LucasB1910/LB_Prak26_CottonCandyFlavour/media/flavor_station_angled_view.jpeg

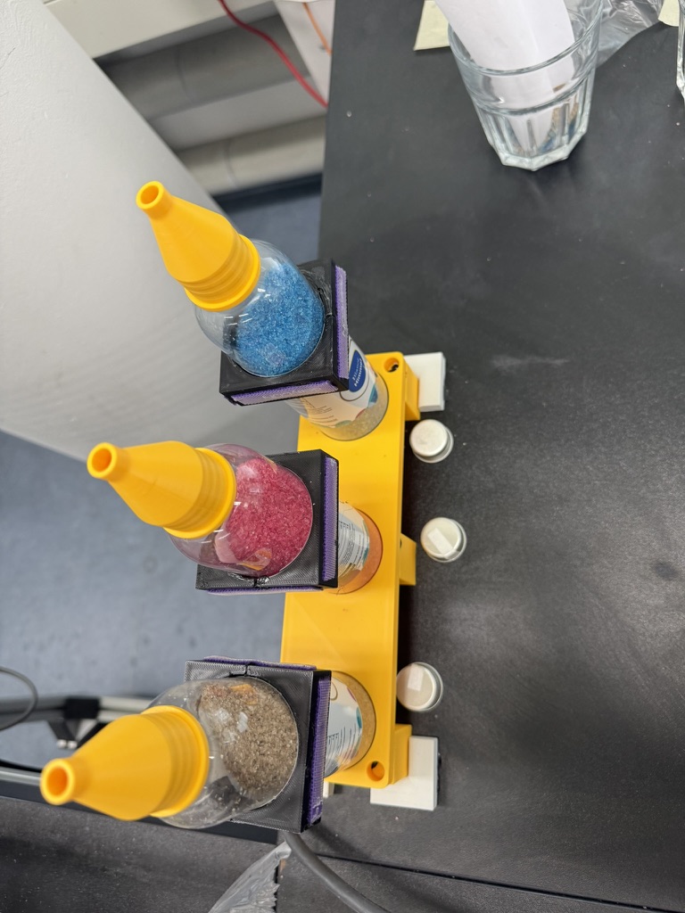
media/flavor_station_angled_view.jpeg
