LucasB1910/LB_Prak26_CottonCandyFlavour/media/flavor_station_docking_view.jpeg

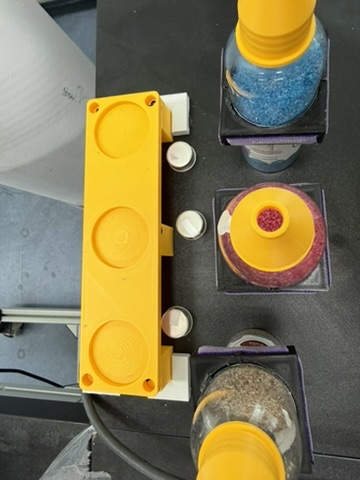
media/flavor_station_docking_view.jpeg
