LucasB1910/LB_Prak26_CottonCandyFlavour/hardware/3d-prints/final_funnel_9.5mm_opening.stl

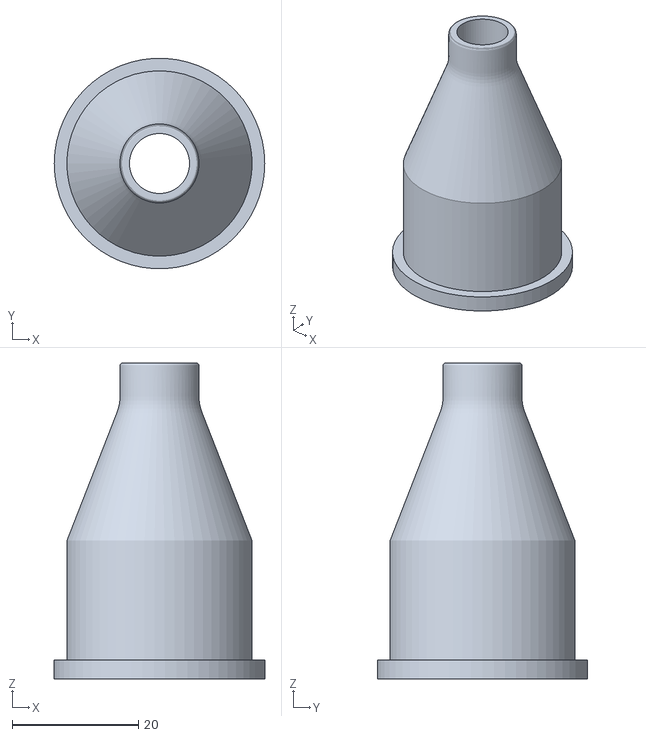
[picture p7: CAD file, 2026-07-26]
hardware/3d-prints/final_funnel_9.5mm_opening.stl
33.3 x 33.3 x 50.0
