LucasB1910/LB_Prak26_CottonCandyFlavour/hardware/3d-prints/final_sugar_gripper_v2.stl

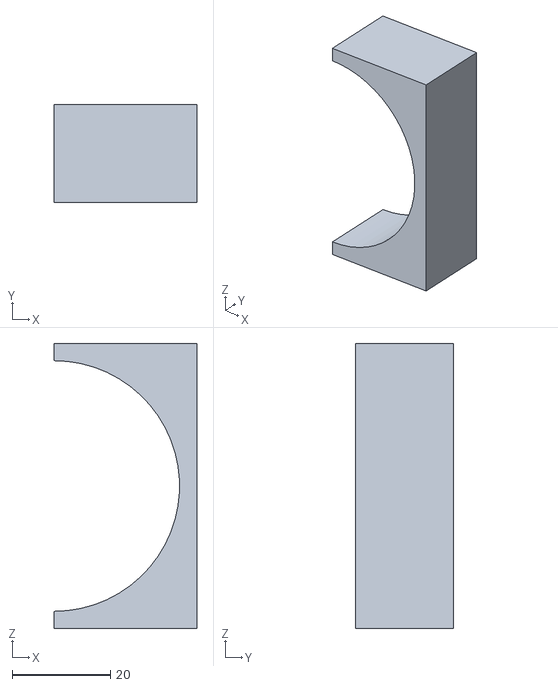
[picture p9: CAD file, 2026-07-26]
hardware/3d-prints/final_sugar_gripper_v2.stl
29.0 x 20.0 x 58.0
