LucasB1910/LB_Prak26_CottonCandyFlavour/hardware/3d-prints/final_sugar_bottle_holder.stl

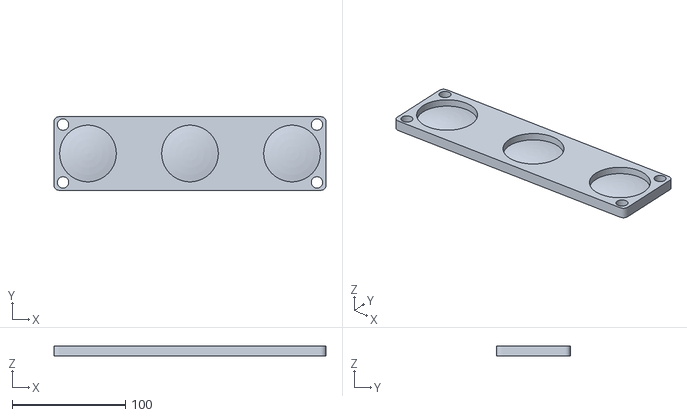
[picture p10: CAD file, 2026-07-26]
hardware/3d-prints/final_sugar_bottle_holder.stl
240.0 x 65.0 x 9.00
