LucasB1910/LB_Prak26_CottonCandyFlavour/hardware/3d-prints/archive/funnel_v3_10.5mm_opening.stl

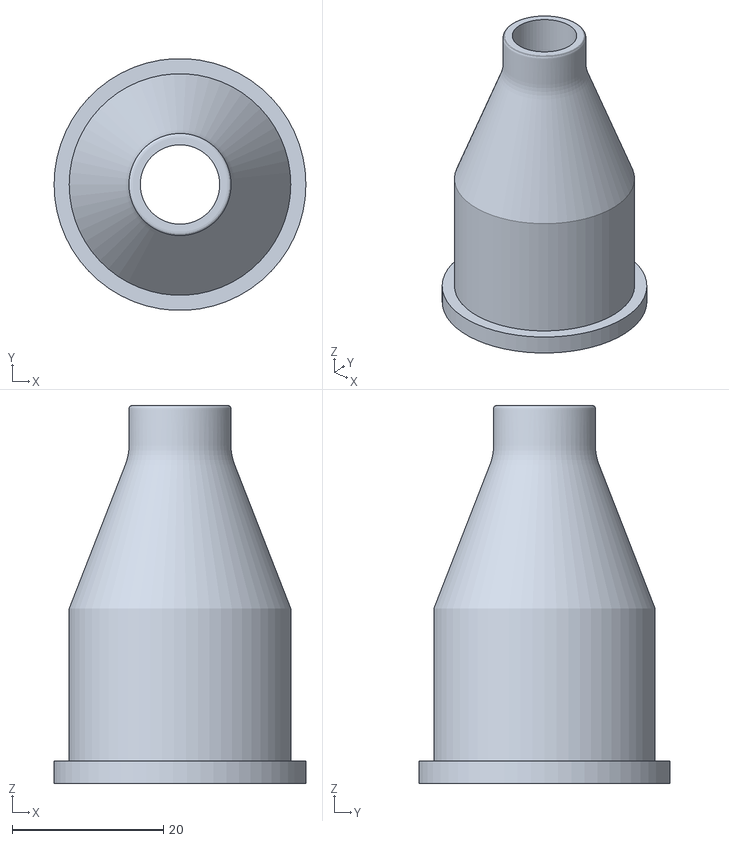
[picture p11: CAD file, 2026-07-26, an earlier design]
hardware/3d-prints/archive/funnel_v3_10.5mm_opening.stl
33.3 x 33.3 x 50.0
