LucasB1910/LB_Prak26_CottonCandyFlavour/hardware/3d-prints/archive/funnel_early_prototype_26-06.stl

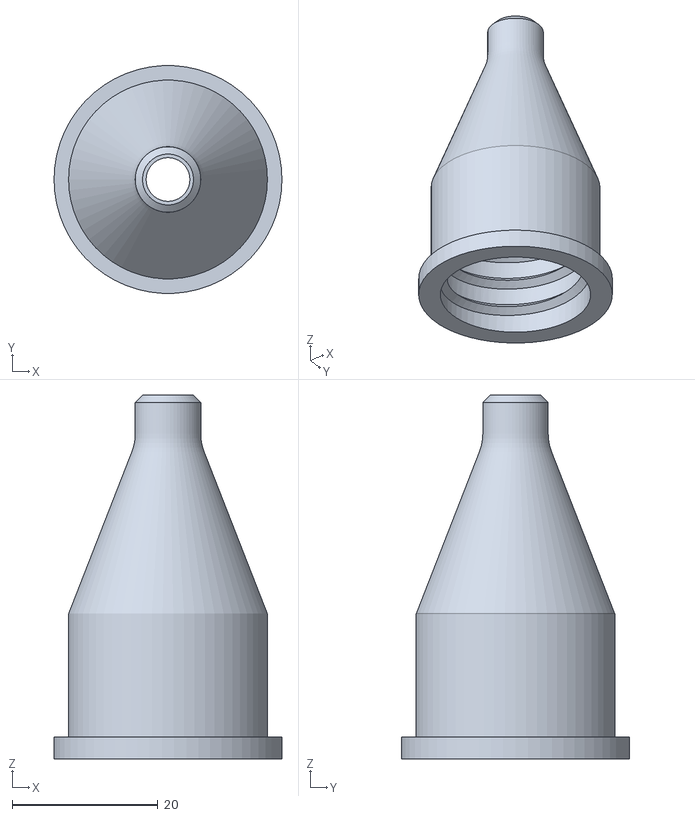
[picture p12: CAD file, 2026-07-26, an earlier design]
hardware/3d-prints/archive/funnel_early_prototype_26-06.stl
31.3 x 31.3 x 50.0
