LucasB1910/LB_Prak26_CottonCandyFlavour/hardware/3d-prints/archive/sugar_gripper_v1_24.5mm.stl

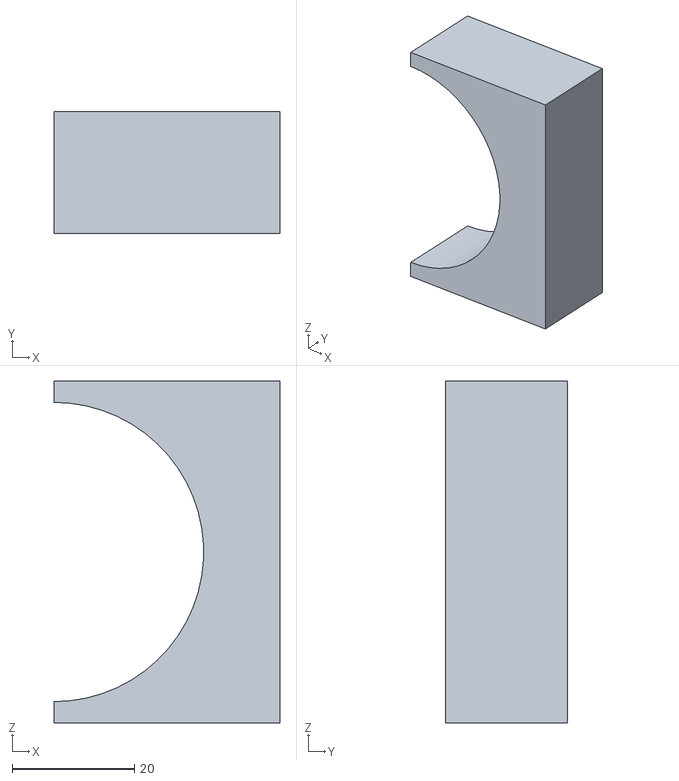
[picture p13: CAD file, 2026-07-26, an earlier design]
hardware/3d-prints/archive/sugar_gripper_v1_24.5mm.stl
37.0 x 20.0 x 56.0
