LucasB1910/LB_Prak26_CottonCandyFlavour/hardware/3d-prints/archive/sugar_dosing_cap_v1.stl

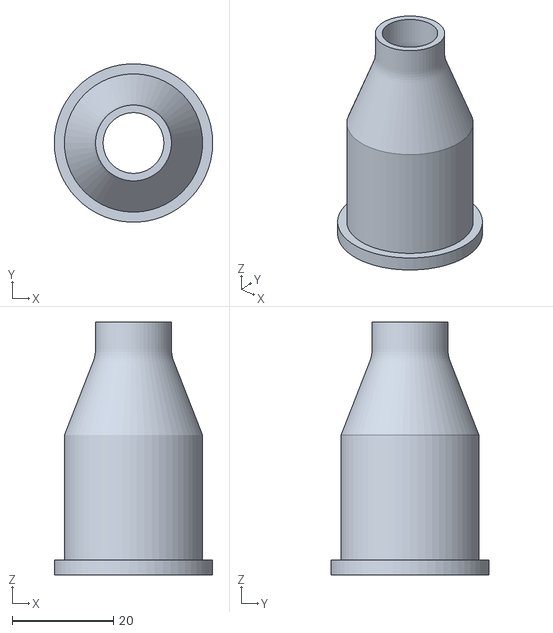
[picture p14: CAD file, 2026-07-26, an earlier design]
hardware/3d-prints/archive/sugar_dosing_cap_v1.stl
31.3 x 31.3 x 50.0
