LucasB1910/LB_Prak26_CottonCandyFlavour/(commit log)

2026-07-26 Add project files: CPEE process, UI, robot programs, 3D prints and media
    [final_funnel_7.5mm_opening.stl, final_sugar_bottle_holder.stl, final_sugar_gripper_v2.stl, funnel_early_prototype_26-06.stl, funnel_v2_9.5mm_opening.stl, funnel_v3_10.5mm_opening.stl, sugar_dosing_cap_v1.stl, sugar_gripper_v1_24.5mm.stl]
2026-07-27 Correct wording, funnel size, credits and hardware details
    [final_funnel_9.5mm_opening.stl, funnel_v1_7.5mm_opening.stl]
